gom9000/xp-eeprom-28C-programmer/CHANGES.md

# CHANGES
This file contains the log of changes of **EEPROM 28C Programmer** eXPerience.

## "mercury" 1.2.0 2020-07-13 Feature release
- Added software "-a" option to set datafile as ascii vs binary

## "mercury" 1.1.0 2020-07-10 Feature release
- Added software "-p" option to print the bus pin number of the RasbperryPI GPIOs (wiringPI numbering)

## "mercury" 1.0.0 2020-07-08 Feature release
- Refactored software path-tree structure and code modules

## 0.1.0 2020-07-05 Draft release
- Created repository *xp-eeprom-28C-programmer* and
- Added README.md, CHANGES.md and TODO.md files
- Added software code for RaspberryPI-3
- Added schematic
- Tested on Atmel 28C16, 28C64 and 28C256
