gom9000/xp-eeprom-28C-programmer/TODO.md

# TODO
This file contains the todo list of **EEPROM 28C Programmer** eXPerience.

## Next Tasks

## Future Tasks
- [ ] Support more 28C-family EEPROMs
- [ ] Refactor address bus with serial-to-parallel shift registers
- [ ] Add all the EEPROM 28C-family operations
