gom9000/xp-eeprom-28C-programmer/(commit log)

2020-07-05 Add schematic
    [eeprom-28C-programmer.sch]
2020-07-21 Add software -p option to print bus pin numbers
2020-07-21 Update schematic with ZIF-28 socket
    [eeprom-28C-programmer.sch]
